meh2481/beatsequencer/README.md

# beatsequencer
Beat sequencer/soundboard in CircuitPython with custom rp2030 PCB
