meh2481/beatsequencer/case/displaySpacer.FCStd

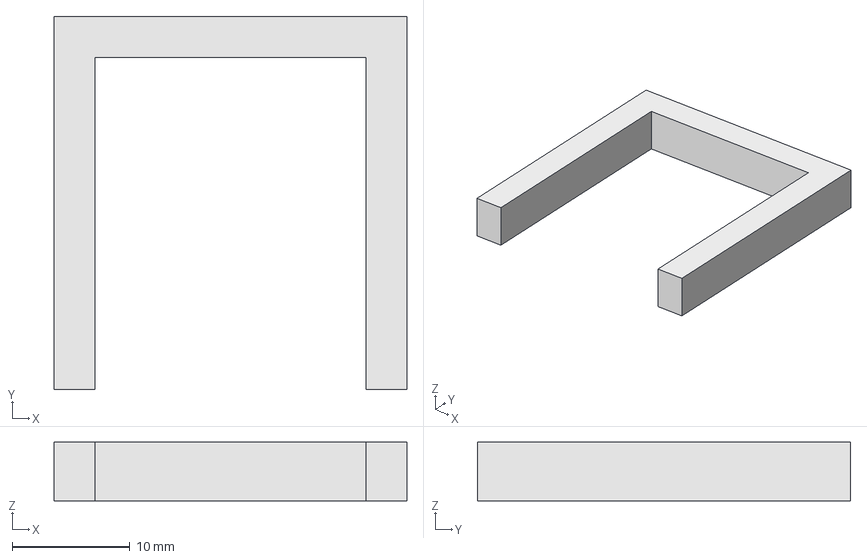
[picture p1: CAD file, 2023-03-02]
case/displaySpacer.FCStd
30.0 x 31.7 x 5.00 mm
