meh2481/beatsequencer/pcb/BeatSequencer.kicad_sch

## KiCad design pcb/BeatSequencer.kicad_sch (2023-03-02)

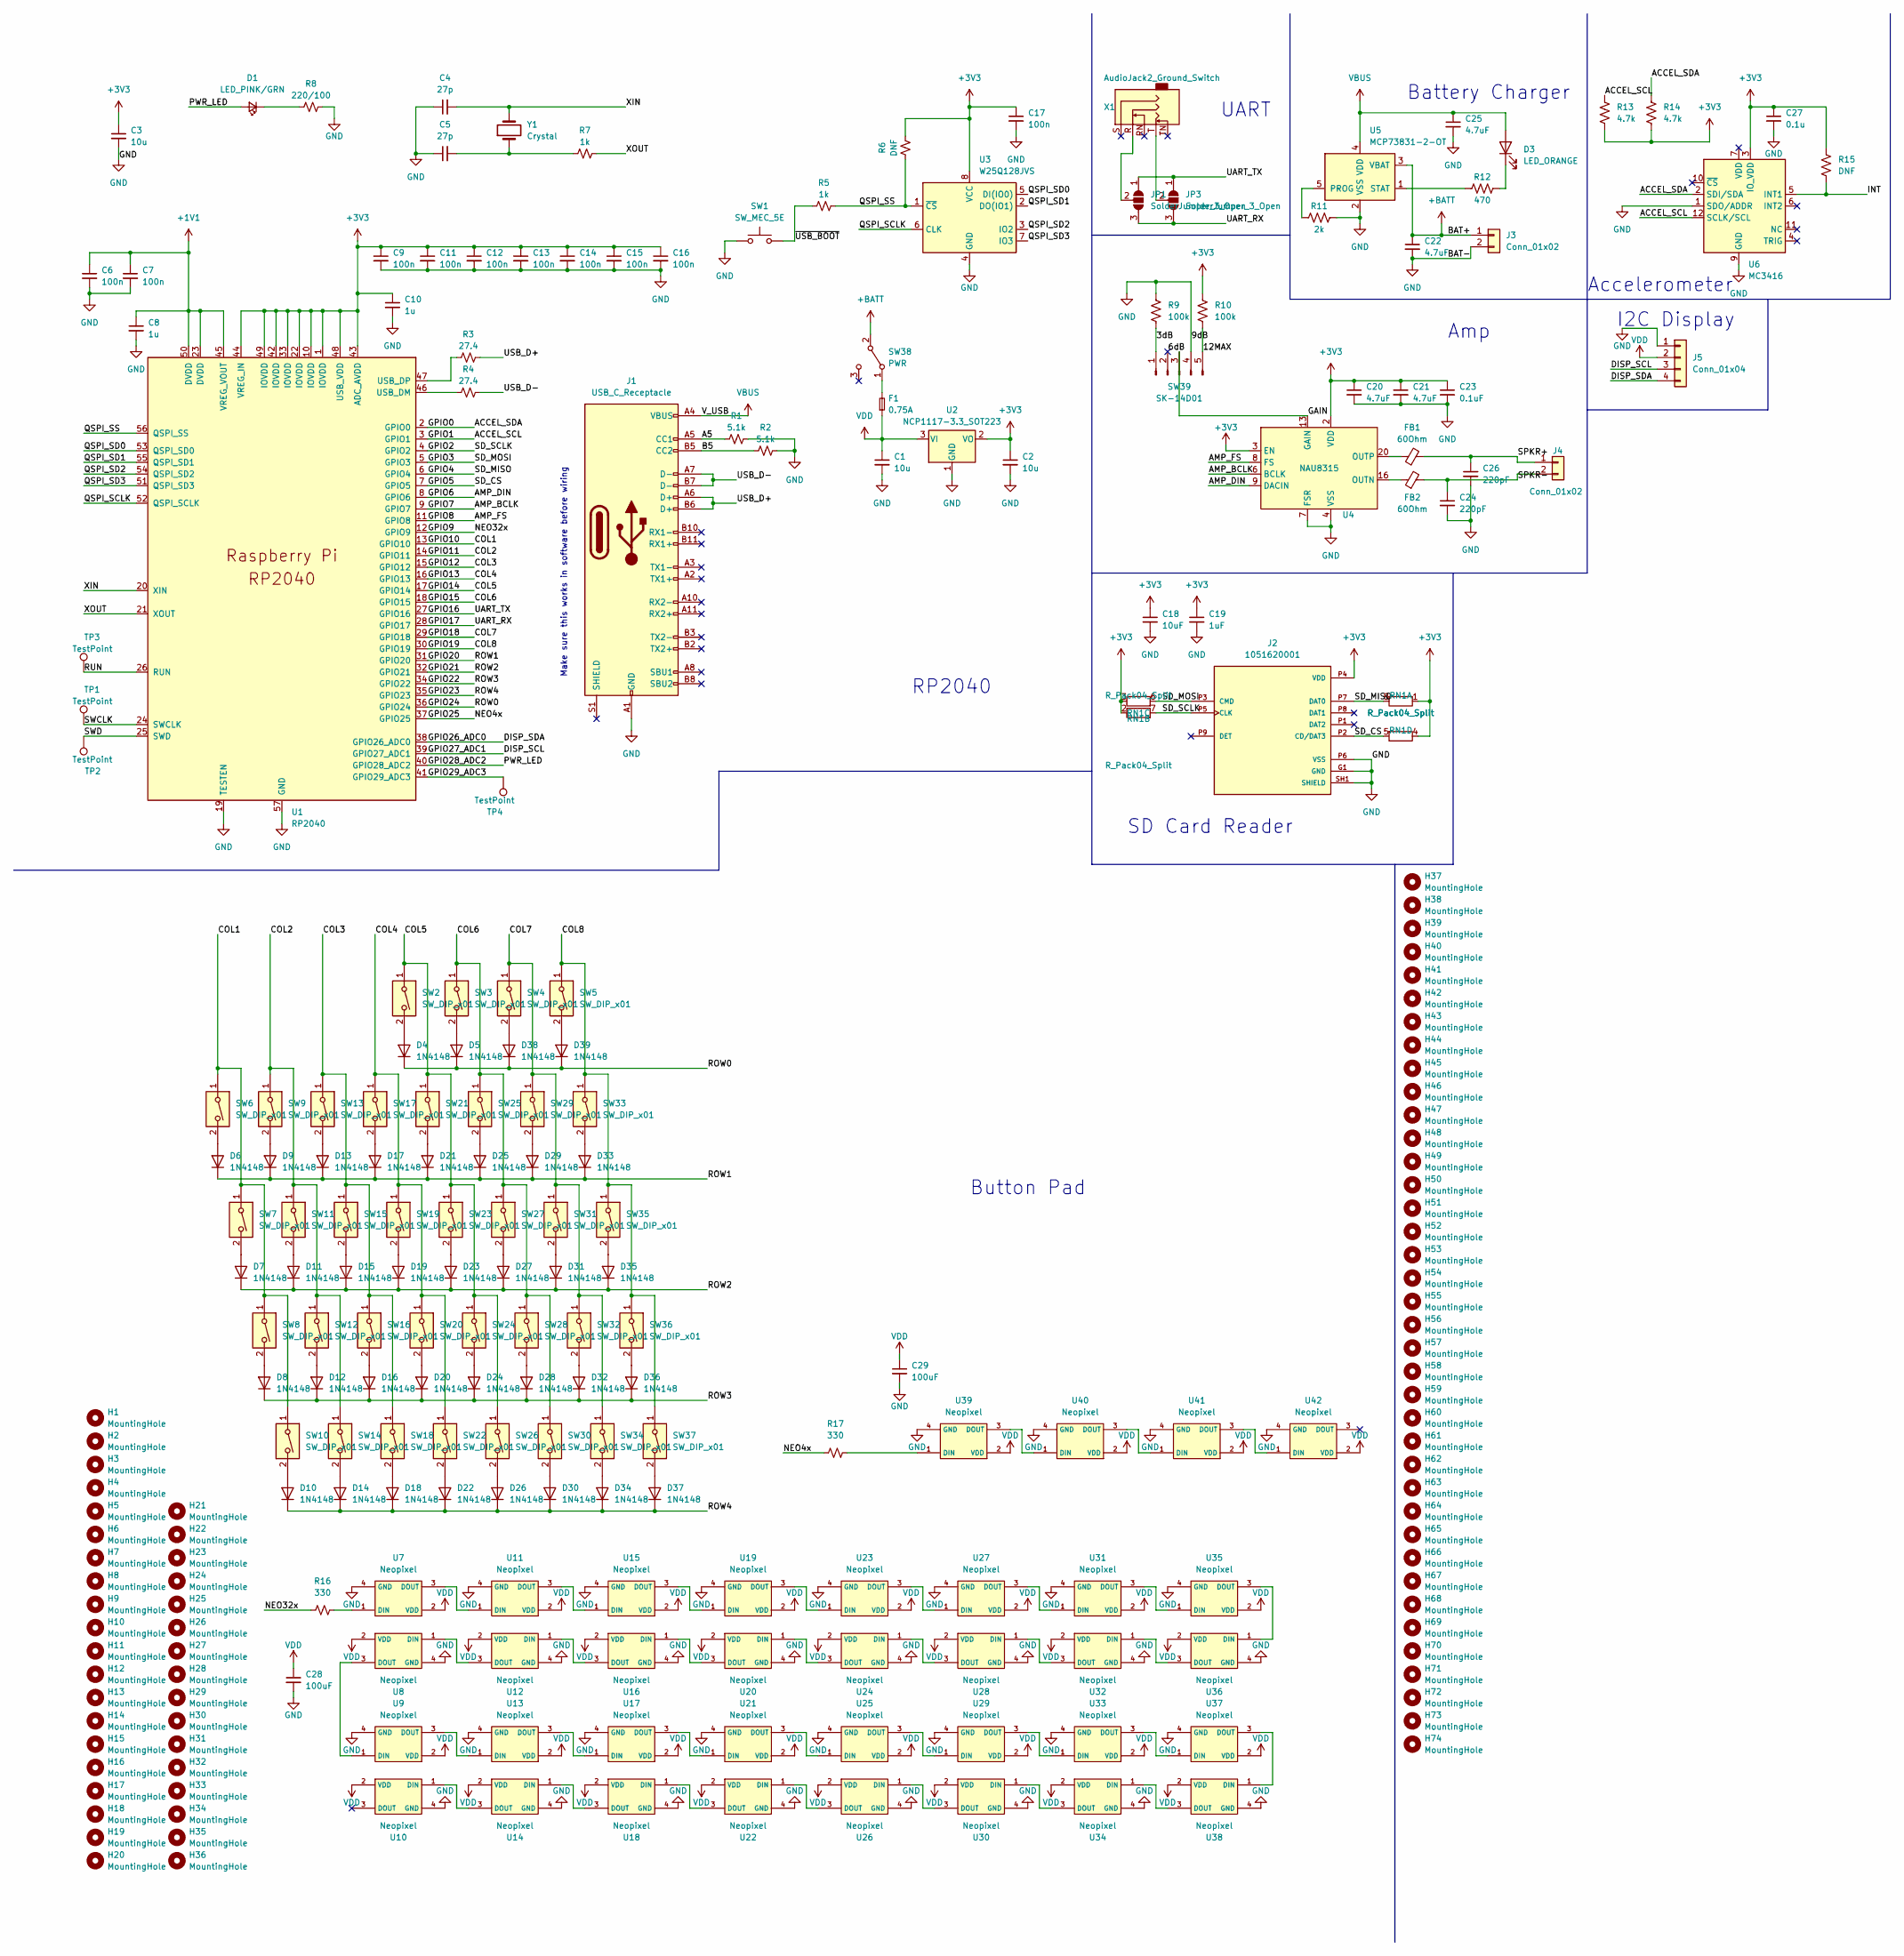
[picture p2: schematic BeatSequencer.kicad_sch]

Parts:
C1, C2, C3: 10u; C_0805_2012Metric
C4, C5: 27p; C_0402_1005Metric
C6, C7, C9, C11, C12, C13, C14, C15, C16, C17: 100n; C_0402_1005Metric
C8, C10: 1u; C_0402_1005Metric
C18: 10uF; C_0805_2012Metric
C19: 1uF; C_0402_1005Metric
C20, C21, C22, C25: 4.7uF; C_0603_1608Metric
C23: 0.1uF; C_0402_1005Metric
C24, C26: 220pF; C_0402_1005Metric
C27: 0.1u; C_0603_1608Metric_Pad1.08x0.95mm_HandSolder
C28, C29: 100uF; CP_Elec_6.3x5.2
D1: LED_PINK/GRN; LED_1206_3216Metric
D3: LED_ORANGE; LED_1206_3216Metric
D4, D5, D6, D7, D8, D9, D10, D11, D12, D13, D14, D15, D16, D17, D18, D19, D20, D21, D22, D23, D24, D25, D26, D27, D28, D29, D30, D31, D32, D33, D34, D35, D36, D37, D38, D39: 1N4148; D_0402_1005Metric
F1: 0.75A; Fuse_0402_1005Metric_Pad0.77x0.64mm_HandSolder
FB1, FB2: 60Ohm; C_0402_1005Metric
H1, H2, H3, H4, H5, H6, H7, H8, H9, H10, H11, H12, H13, H14, H15, H16, H17, H18, H19, H20, H21, H22, H23, H24, H25, H26, H27, H28, H29, H30, H31, H32, H33, H34, H35, H36: MountingHole; MountingHole_3.2mm_M3
H37, H38, H39, H40, H41, H42, H43, H44, H45, H46, H47, H48, H49, H50, H51, H52, H53, H54, H55, H56, H57, H58, H59, H60, H61, H62, H63, H64, H65, H66, H67, H68, H69, H70, H71, H72, H73, H74: MountingHole; MountingHole_2.2mm_M2
J1: USB_C_Receptacle; GCT_USB4105-GF-A
J2: 1051620001; MOLEX_1051620001; PARTREV D
J3: Conn_01x02; PinHeader_1x02_P2.54mm_Vertical
J4: Conn_01x02; PinSocket_1x02_P2.54mm_Vertical
J5: Conn_01x04; PinHeader_1x04_P2.54mm_Vertical
JP1, JP3: SolderJumper_3_Open; SolderJumper-3_P1.3mm_Open_RoundedPad1.0x1.5mm
R1, R2: 5.1k; R_0402_1005Metric
R3, R4: 27.4; R_0402_1005Metric
R5, R7: 1k; R_0402_1005Metric
R6: DNF; R_0402_1005Metric
R8: 220/100; R_0603_1608Metric
R9, R10: 100k; R_0402_1005Metric
R11: 2k; R_0402_1005Metric
R12: 470; R_0402_1005Metric
R13, R14: 4.7k; R_0603_1608Metric_Pad0.98x0.95mm_HandSolder
R15: DNF; R_0603_1608Metric_Pad0.98x0.95mm_HandSolder
R16, R17: 330; R_0603_1608Metric
RN1: R_Pack04_Split; R_Array_Convex_4x0612
SW1: SW_MEC_5E; SW_SPST_PTS810
SW2, SW3, SW4, SW5, SW6, SW7, SW8, SW9, SW10, SW11, SW12, SW13, SW14, SW15, SW16, SW17, SW18, SW19, SW20, SW21, SW22, SW23, SW24, SW25, SW26, SW27, SW28, SW29, SW30, SW31, SW32, SW33, SW34, SW35, SW36, SW37: SW_DIP_x01; Silicone Button Ring_L
SW38: PWR; EG1206A
SW39: SK-14D01; SK-14D01 SP4T Switch
TP1, TP2, TP3, TP4: TestPoint; TestPoint_Pad_D1.5mm
U1: RP2040; RP2040-QFN-56
U2: NCP1117-3.3_SOT223; SOT-223-3_TabPin2
U3: W25Q128JVS; SOIC-8_5.23x5.23mm_P1.27mm
U4: NAU8315; QFN-20-1EP_4x4mm_P0.5mm_EP2.5x2.5mm_ThermalVias
U5: MCP73831-2-OT; SOT-23-5
U6: MC3416; LGA-12_2x2mm_P0.5mm
U7, U8, U9, U10, U11, U12, U13, U14, U15, U16, U17, U18, U19, U20, U21, U22, U23, U24, U25, U26, U27, U28, U29, U30, U31, U32, U33, U34, U35, U36, U37, U38, U39, U40, U41, U42: Neopixel; NeoPixel_3535
X1: AudioJack2_Ground_Switch; Jack_3.5mm_CUI_SJ1-3525N_Horizontal
Y1: Crystal; Crystal_SMD_HC49-SD

Connections:
3dB: R9.2, SW39.1
6dB: SW39.2
12MAX: R10.2, SW39.5
+1V1: C6.1, C7.1, C8.1, U1.23 (DVDD), U1.45 (VREG_VOUT), U1.50 (DVDD)
+3V3: C2.1, C3.1, C9.1, C10.1, C11.1, C12.1, C13.1, C14.1, C15.1, C16.1, C17.1, C18.1, C19.1, C20.1, C21.1, C23.1, C27.1, J2.P4 (VDD), R6.2, R10.1, R13.2, R14.2, R15.1, RN1.1 (R1.1), RN1.2 (R2.1), RN1.3 (R3.1), RN1.4 (R4.1), U1.1 (IOVDD), U1.10 (IOVDD), U1.22 (IOVDD), U1.33 (IOVDD), U1.42 (IOVDD), U1.43 (ADC_AVDD), U1.44 (VREG_IN), U1.48 (USB_VDD), U1.49 (IOVDD), U2.2 (VO), U3.8 (VCC), U4.2 (VDD), U4.3 (EN), U4.11 (VDD), U4.14 (VDD), U6.3 (IO_VDD)
+BATT: C22.1, J3.1, SW38.2 (B), U5.3 (VBAT)
A5: J1.A5 (CC1), R1.1
ACCEL_SCL: R13.1, U1.3 (GPIO1), U6.12 (SCLK/SCL)
ACCEL_SDA: R14.1, U1.2 (GPIO0), U6.2 (SDI/SDA)
AMP_BCLK: U1.9 (GPIO7), U4.6 (BCLK)
AMP_DIN: U1.8 (GPIO6), U4.9 (DACIN)
AMP_FS: U1.11 (GPIO8), U4.8 (FS)
B5: J1.B5 (CC2), R2.1
COL1: SW6.1, SW7.1, SW8.1, SW10.1, U1.13 (GPIO10)
COL2: SW9.1, SW11.1, SW12.1, SW14.1, U1.14 (GPIO11)
COL3: SW13.1, SW15.1, SW16.1, SW18.1, U1.15 (GPIO12)
COL4: SW17.1, SW19.1, SW20.1, SW22.1, U1.16 (GPIO13)
COL5: SW2.1, SW21.1, SW23.1, SW24.1, SW26.1, U1.17 (GPIO14)
COL6: SW3.1, SW25.1, SW27.1, SW28.1, SW30.1, U1.18 (GPIO15)
COL7: SW4.1, SW29.1, SW31.1, SW32.1, SW34.1, U1.29 (GPIO18)
COL8: SW5.1, SW33.1, SW35.1, SW36.1, SW37.1, U1.30 (GPIO19)
DISP_SCL: J5.3, U1.39 (GPIO27_ADC1)
DISP_SDA: J5.4, U1.38 (GPIO26_ADC0)
GAIN: SW39.3, U4.13 (GAIN)
GND: C1.2, C2.2, C3.2, C4.1, C5.1, C6.2, C7.2, C8.2, C9.2, C10.2, C11.2, C12.2, C13.2, C14.2, C15.2, C16.2, C17.2, C18.2, C19.2, C20.2, C21.2, C22.2, C23.2, C24.2, C25.2, C26.2, C27.2, C28.2, C29.2, J1.A1 (GND), J1.A12 (GND), J1.B1 (GND), J1.B12 (GND), J2.G1 (GND), J2.G2 (GND), J2.G3 (GND), J2.G4 (GND), J2.P6 (VSS), J2.SH1 (SHIELD), J2.SH2 (SHIELD), J3.2, J5.1, R1.2, R2.2, R8.2, R9.1, R11.2, SW1.1, SW39.4, U1.19 (TESTEN), U1.57 (GND), U2.1 (GND), U3.4 (GND), U4.4 (VSS), U4.7 (FSR), U4.12 (VSS), U4.17 (VSS), U4.18 (VSS), U4.19 (VSS), U4.21 (VSS), U5.2 (VSS), U6.1 (SDO/ADDR), U6.9 (GND), U7.4 (GND), U8.4 (GND), U9.4 (GND), U10.4 (GND), U11.4 (GND), U12.4 (GND), U13.4 (GND), U14.4 (GND), U15.4 (GND), U16.4 (GND), U17.4 (GND), U18.4 (GND), U19.4 (GND), U20.4 (GND), U21.4 (GND), U22.4 (GND), U23.4 (GND), U24.4 (GND), U25.4 (GND), U26.4 (GND), U27.4 (GND), U28.4 (GND), U29.4 (GND), U30.4 (GND), U31.4 (GND), U32.4 (GND), U33.4 (GND), U34.4 (GND), U35.4 (GND), U36.4 (GND), U37.4 (GND), U38.4 (GND), U39.4 (GND), U40.4 (GND), U41.4 (GND), U42.4 (GND)
GPIO2: J2.P5 (CLK), RN1.7 (R2.2), U1.4 (GPIO2)
GPIO3: J2.P3 (CMD), RN1.6 (R3.2), U1.5 (GPIO3)
GPIO4: J2.P7 (DAT0), RN1.8 (R1.2), U1.6 (GPIO4)
GPIO5: J2.P2 (CD/DAT3), RN1.5 (R4.2), U1.7 (GPIO5)
GPIO9: R16.1, U1.12 (GPIO9)
GPIO16: JP1.1 (A), JP3.1 (A), U1.27 (GPIO16)
GPIO17: JP1.3 (B), JP3.3 (B), U1.28 (GPIO17)
GPIO20: D6.1 (K), D9.1 (K), D13.1 (K), D17.1 (K), D21.1 (K), D25.1 (K), D29.1 (K), D33.1 (K), U1.31 (GPIO20)
GPIO21: D7.1 (K), D11.1 (K), D15.1 (K), D19.1 (K), D23.1 (K), D27.1 (K), D31.1 (K), D35.1 (K), U1.32 (GPIO21)
GPIO22: D8.1 (K), D12.1 (K), D16.1 (K), D20.1 (K), D24.1 (K), D28.1 (K), D32.1 (K), D36.1 (K), U1.34 (GPIO22)
GPIO23: D10.1 (K), D14.1 (K), D18.1 (K), D22.1 (K), D26.1 (K), D30.1 (K), D34.1 (K), D37.1 (K), U1.35 (GPIO23)
GPIO24: D4.1 (K), D5.1 (K), D38.1 (K), D39.1 (K), U1.36 (GPIO24)
GPIO25: R17.1, U1.37 (GPIO25)
GPIO28_ADC2: D1.2 (A), U1.40 (GPIO28_ADC2)
GPIO29_ADC3: TP4.1, U1.41 (GPIO29_ADC3)
INT: R15.2, U6.5 (INT1)
unnamed: C5.2, R7.1, Y1.1
unnamed: D1.1 (K), R8.1
unnamed: D3.1 (K), R12.2
unnamed: D4.2 (A), SW2.2
unnamed: D5.2 (A), SW3.2
unnamed: D6.2 (A), SW6.2
unnamed: D7.2 (A), SW7.2
unnamed: D8.2 (A), SW8.2
unnamed: D9.2 (A), SW9.2
unnamed: D10.2 (A), SW10.2
unnamed: D11.2 (A), SW11.2
unnamed: D12.2 (A), SW12.2
unnamed: D13.2 (A), SW13.2
unnamed: D14.2 (A), SW14.2
unnamed: D15.2 (A), SW15.2
unnamed: D16.2 (A), SW16.2
unnamed: D17.2 (A), SW17.2
unnamed: D18.2 (A), SW18.2
unnamed: D19.2 (A), SW19.2
unnamed: D20.2 (A), SW20.2
unnamed: D21.2 (A), SW21.2
unnamed: D22.2 (A), SW22.2
unnamed: D23.2 (A), SW23.2
unnamed: D24.2 (A), SW24.2
unnamed: D25.2 (A), SW25.2
unnamed: D26.2 (A), SW26.2
unnamed: D27.2 (A), SW27.2
unnamed: D28.2 (A), SW28.2
unnamed: D29.2 (A), SW29.2
unnamed: D30.2 (A), SW30.2
unnamed: D31.2 (A), SW31.2
unnamed: D32.2 (A), SW32.2
unnamed: D33.2 (A), SW33.2
unnamed: D34.2 (A), SW34.2
unnamed: D35.2 (A), SW35.2
unnamed: D36.2 (A), SW36.2
unnamed: D37.2 (A), SW37.2
unnamed: D38.2 (A), SW4.2
unnamed: D39.2 (A), SW5.2
unnamed: F1.2, SW38.1 (A)
unnamed: FB1.1, U4.20 (OUTP)
unnamed: FB2.1, U4.16 (OUTN)
unnamed: JP1.2 (C), X1.R
unnamed: JP3.2 (C), X1.T
unnamed: R3.1, U1.47 (USB_DP)
unnamed: R4.1, U1.46 (USB_DM)
unnamed: R11.1, U5.5 (PROG)
unnamed: R12.1, U5.1 (STAT)
unnamed: R16.2, U7.1 (DIN)
unnamed: R17.2, U39.1 (DIN)
unnamed: U4.1 (NC), U4.5 (NC), U4.10 (NC), U4.15 (NC)
unnamed: U8.3 (DOUT), U9.1 (DIN)
unnamed: U10.1 (DIN), U14.3 (DOUT)
unnamed: U7.3 (DOUT), U11.1 (DIN)
unnamed: U11.3 (DOUT), U15.1 (DIN)
unnamed: U12.1 (DIN), U16.3 (DOUT)
unnamed: U8.1 (DIN), U12.3 (DOUT)
unnamed: U9.3 (DOUT), U13.1 (DIN)
unnamed: U13.3 (DOUT), U17.1 (DIN)
unnamed: U14.1 (DIN), U18.3 (DOUT)
unnamed: U15.3 (DOUT), U19.1 (DIN)
unnamed: U16.1 (DIN), U20.3 (DOUT)
unnamed: U17.3 (DOUT), U21.1 (DIN)
unnamed: U18.1 (DIN), U22.3 (DOUT)
unnamed: U19.3 (DOUT), U23.1 (DIN)
unnamed: U20.1 (DIN), U24.3 (DOUT)
unnamed: U21.3 (DOUT), U25.1 (DIN)
unnamed: U22.1 (DIN), U26.3 (DOUT)
unnamed: U23.3 (DOUT), U27.1 (DIN)
unnamed: U24.1 (DIN), U28.3 (DOUT)
unnamed: U25.3 (DOUT), U29.1 (DIN)
unnamed: U26.1 (DIN), U30.3 (DOUT)
unnamed: U27.3 (DOUT), U31.1 (DIN)
unnamed: U28.1 (DIN), U32.3 (DOUT)
unnamed: U29.3 (DOUT), U33.1 (DIN)
unnamed: U30.1 (DIN), U34.3 (DOUT)
unnamed: U31.3 (DOUT), U35.1 (DIN)
unnamed: U32.1 (DIN), U36.3 (DOUT)
unnamed: U33.3 (DOUT), U37.1 (DIN)
unnamed: U34.1 (DIN), U38.3 (DOUT)
unnamed: U35.3 (DOUT), U36.1 (DIN)
unnamed: U37.3 (DOUT), U38.1 (DIN)
unnamed: U39.3 (DOUT), U40.1 (DIN)
unnamed: U40.3 (DOUT), U41.1 (DIN)
unnamed: U41.3 (DOUT), U42.1 (DIN)
QSPI_SCLK: U1.52 (QSPI_SCLK), U3.6 (CLK)
QSPI_SD0: U1.53 (QSPI_SD0), U3.5 (DI(IO0))
QSPI_SD1: U1.55 (QSPI_SD1), U3.2 (DO(IO1))
QSPI_SD2: U1.54 (QSPI_SD2), U3.3 (IO2)
QSPI_SD3: U1.51 (QSPI_SD3), U3.7 (IO3)
QSPI_SS: R5.2, R6.1, U1.56 (QSPI_SS), U3.1 (~CS)
RUN: TP3.1, U1.26 (RUN)
SPKR+: C26.1, FB1.2, J4.1
SPKR-: C24.1, FB2.2, J4.2
SWCLK: TP1.1, U1.24 (SWCLK)
SWD: TP2.1, U1.25 (SWD)
USB_D+: J1.A6 (D+), J1.B6 (D+), R3.2
USB_D-: J1.A7 (D-), J1.B7 (D-), R4.2
VBUS: C25.1, D3.2 (A), J1.A4 (VBUS), J1.A9 (VBUS), J1.B4 (VBUS), J1.B9 (VBUS), U5.4 (VDD)
VDD: C1.1, C28.1, C29.1, F1.1, J5.2, U2.3 (VI), U7.2 (VDD), U8.2 (VDD), U9.2 (VDD), U10.2 (VDD), U11.2 (VDD), U12.2 (VDD), U13.2 (VDD), U14.2 (VDD), U15.2 (VDD), U16.2 (VDD), U17.2 (VDD), U18.2 (VDD), U19.2 (VDD), U20.2 (VDD), U21.2 (VDD), U22.2 (VDD), U23.2 (VDD), U24.2 (VDD), U25.2 (VDD), U26.2 (VDD), U27.2 (VDD), U28.2 (VDD), U29.2 (VDD), U30.2 (VDD), U31.2 (VDD), U32.2 (VDD), U33.2 (VDD), U34.2 (VDD), U35.2 (VDD), U36.2 (VDD), U37.2 (VDD), U38.2 (VDD), U39.2 (VDD), U40.2 (VDD), U41.2 (VDD), U42.2 (VDD)
XIN: C4.2, U1.20 (XIN), Y1.2
XOUT: R7.2, U1.21 (XOUT)
~USB_BOOT: R5.1, SW1.2

Notes on the sheet:
Amp
RP2040
Button Pad
UART
Accelerometer
Battery Charger
I2C Display
SD Card Reader
Make sure this works in software before wiring
