meh2481/beatsequencer/code/master/beat_sequencer/config.py

NEOPIXEL_TOP_OFF = (0, 255, 0)
NEOPIXEL_TOP_ON = (0, 0, 255)

PLAYER_NAME = "Maxwell"
PLAYER_NAMES = ["Maxwell", "Roselynn"]

STARTREK_COLORS = [
    (255, 0, 0),  # 0xFF0000
    (128, 0, 0),  # 0x800000
    (255, 128, 0),  # 0xFF8000
    (255, 255, 0),  # 0xFFFF00
    (128, 128, 0),  # 0x808000
    (0, 128, 0),  # 0x008000
    (0, 255, 255),  # 0x00FFFF
    (0, 128, 128),  # 0x008080
    (0, 0, 255),  # 0x0000FF
    (0, 0, 128),  # 0x000080
    (128, 0, 128),  # 0x800080
    (255, 0, 128)  # 0xFF0080
]

PATCH_COLORS = [
    (255, 0, 0),
    (0, 255, 0),
    (0, 0, 255),
    (255, 255, 0)
]

SNAKE_HEAD_COLOR = (0, 255, 100)
SNAKE_BODY_COLOR = (0, 255, 0)
FRUIT_COLOR = (255, 0, 0)
