meh2481/beatsequencer/(commit log)

2022-10-04 Faster anim by only trellis sync every 20 frames
2022-10-05 Fix some kick bugs
    [code.py]
2022-10-05 Switch over to I2S for better sound
2023-03-02 Switch over to new setup on new pcb
2023-03-02 Add case and PCB design
    [BeatSequencer.kicad_sch, case_bottom2.FCStd, displaySpacer.FCStd]
2023-03-02 Add BOM file
    [BeatSequencer_bom.csv]
2023-03-04 moar better case, initial mode switching
    [case_bottom2.FCStd]
2023-03-04 Better mode switching
2023-03-04 Tempo select with accelerometer
2023-03-06 Add board reset
2023-04-22 Case modifications
    [case_bottom2.FCStd]
2023-04-23 Moar case tweaks
2023-04-24 Case update, remove SD card, LED brightness control
2023-04-26 Styling, start on startrek fx (broken)
    [beat_sequencer.py, buttons.py, code.py, snake.py, startrek.py]
2023-05-08 UART sync play
2023-05-08 Fix visual bug in slave sync, remove commented code
    [sync_sequencer.py]
